ltu-formula-hybrid/pimu/documents/schematic.png

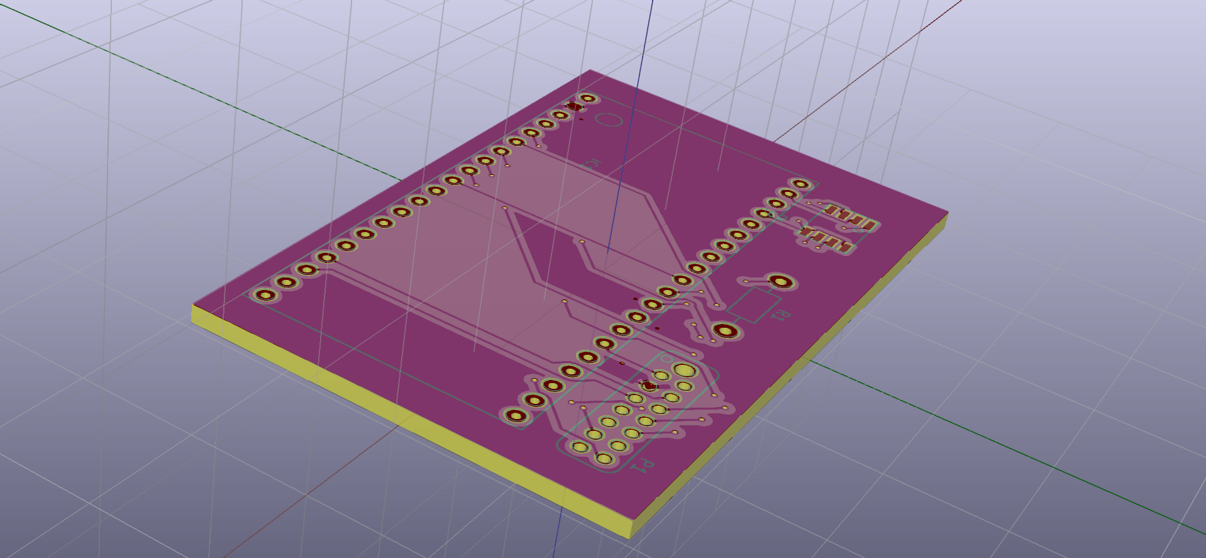
documents/schematic.png
