ltu-formula-hybrid/pimu/(list of files, cad)

Other CAD files:
documents/schematic.kicad_pcb.ipt
