ltu-formula-hybrid/pimu/documents/schematic.pdf

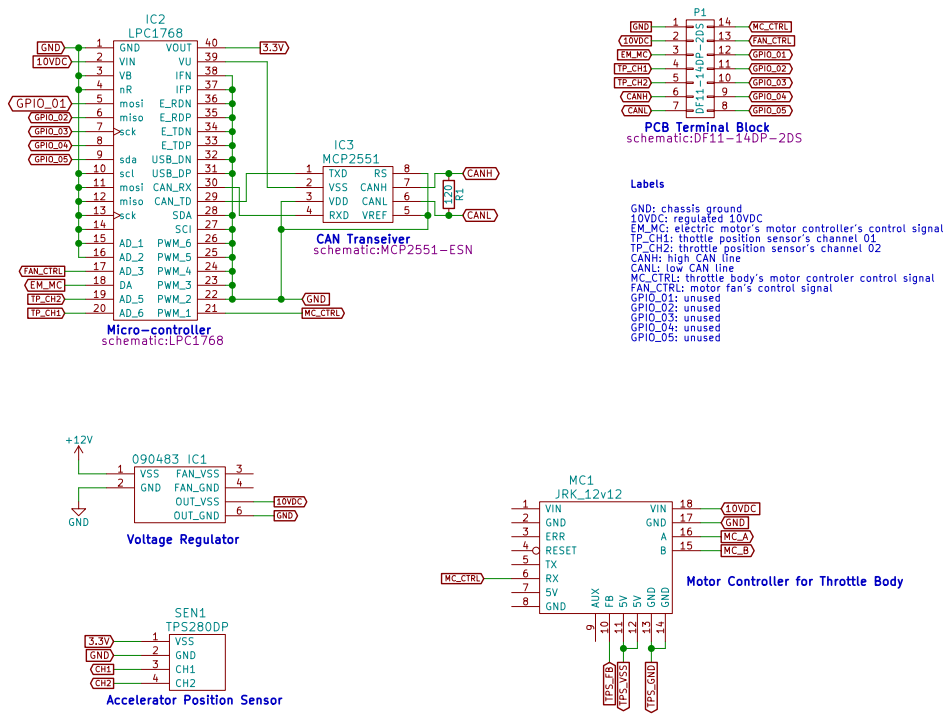
[picture p4: page 1]

10VDC: regulated 10VDC
EM_MC: electric motor's motor controller's control signal
TP_CH1: thottle position sensor's channel 01
TP_CH2: throttle position sensor's channel 02
CANH: high CAN line CANL: low CAN line MC_CTRL: throttle body's motor controler control signal

Motor Controller for Throttle Body
