ltu-formula-hybrid/pimu/documents/schematic-B.Cu.pdf

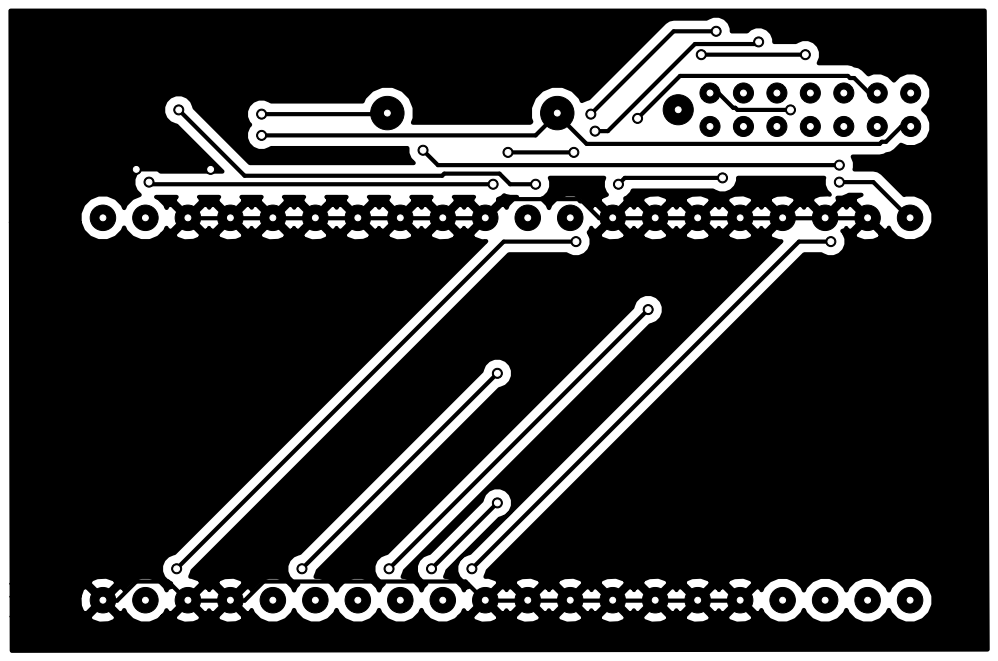
[picture p5: page 1]
