ltu-formula-hybrid/pimu/documents/schematic-F.Cu.pdf

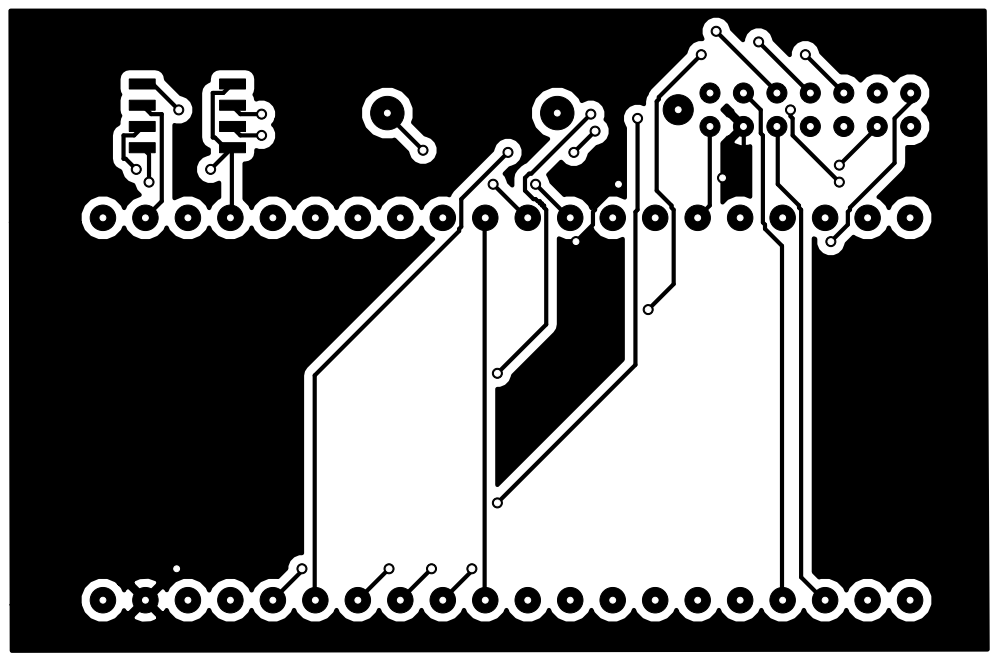
[picture p6: page 1]
