ltu-formula-hybrid/pimu/documents/schematic-F.SilkS.pdf

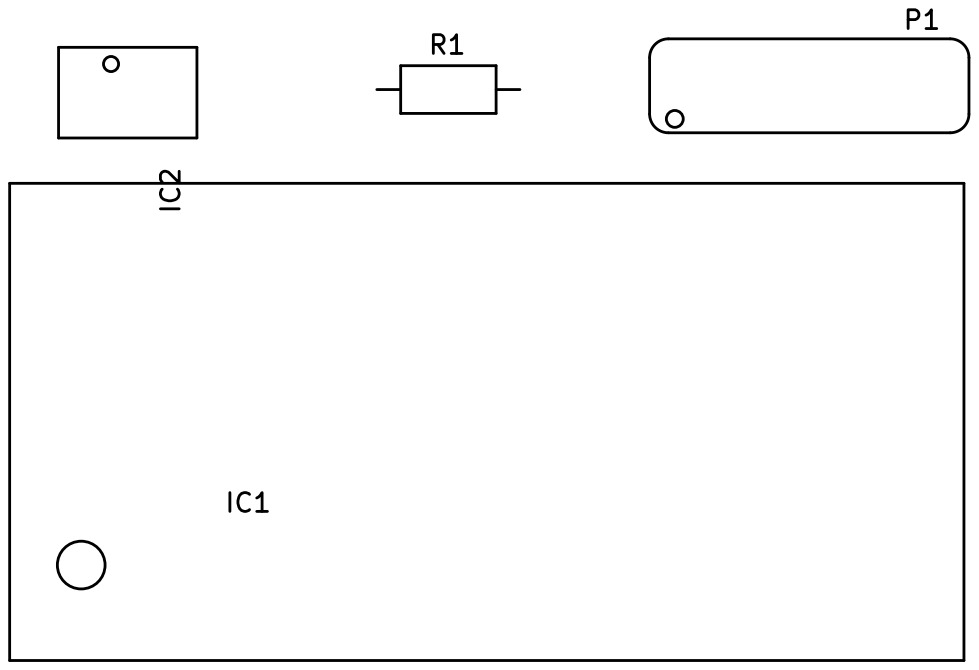
[picture p7: page 1]
