ltu-formula-hybrid/pimu/documents/schematic.kicad_pcb

## KiCad design documents/schematic.kicad_pcb (2016-03-19)

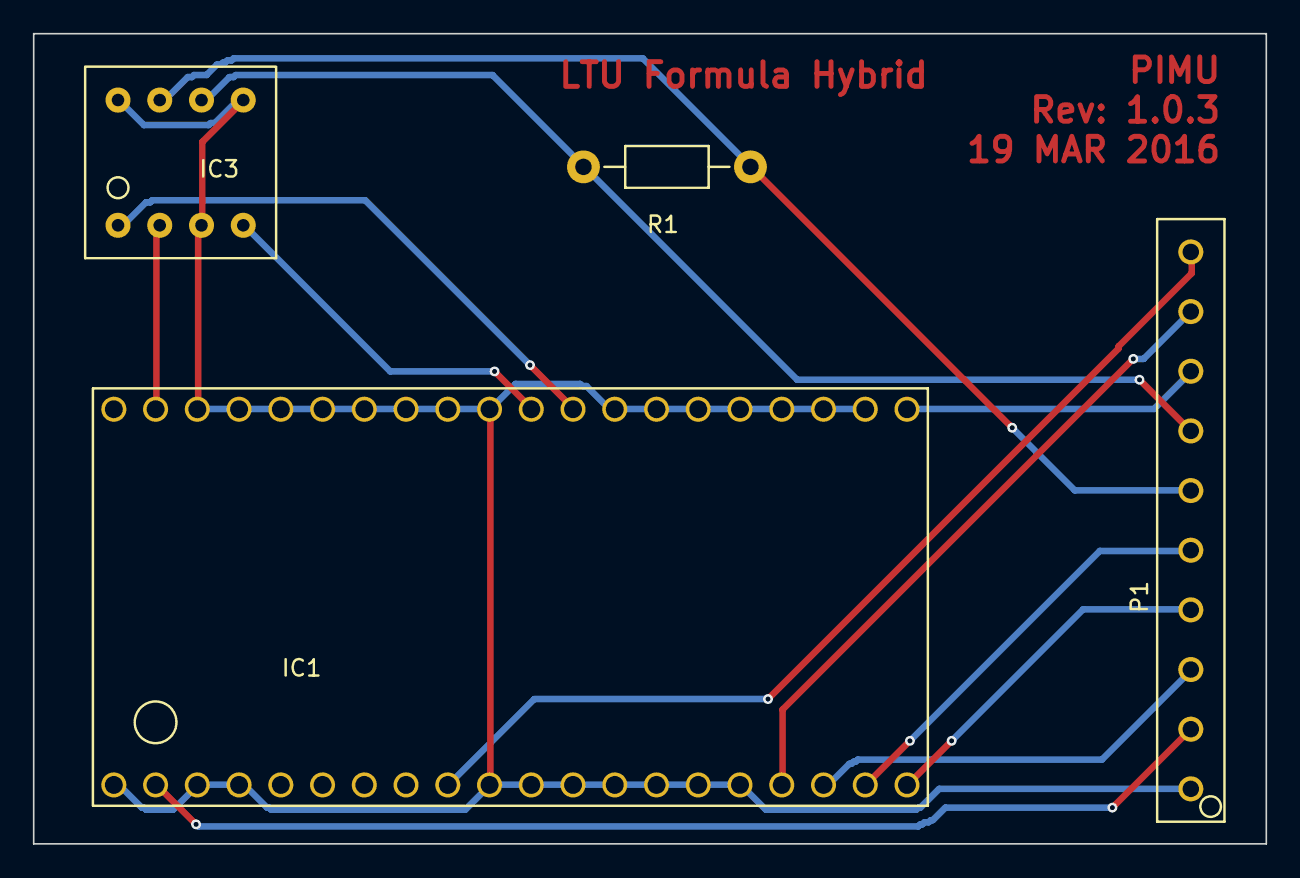
[picture p8: board schematic.kicad_pcb from above]

Board: 2 copper layers, 75.0 x 49.3 mm, 4 parts (0 on the bottom side), 13 nets.

Parts:
IC1: LPC1768
IC3: MCP2551; MCP2551-ESN
P1: CONN_01X10; CONN_01X10_CUST
R1: 120; Resistor_Horizontal_RM10mm

Connections:
10VDC: IC1.2, P1.2
CANH: IC3.7, P1.6, R1.1
CANL: IC3.6, P1.7, R1.2
EM_MC: IC1.18, P1.3
FAN_CTRL: IC1.17, P1.9
GND: IC1.1, IC1.3, IC1.4, IC1.10, IC1.11, IC1.12, IC1.13, IC1.14, IC1.15, IC1.16, IC1.22, IC1.23, IC1.24, IC1.25, IC1.26, IC1.27, IC1.28, IC1.31, IC1.32, IC1.33, IC1.34, IC1.35, IC1.36, IC1.37, IC1.38, IC3.3, IC3.5, IC3.8, P1.1
MC_CTRL: IC1.21, P1.8
unnamed: IC1.29, IC3.1
unnamed: IC1.30, IC3.4
unnamed: IC1.39, IC3.2
STARTER_SIG: IC1.9, P1.10
TP_CH1: IC1.20, P1.4
TP_CH2: IC1.19, P1.5
