ltu-formula-hybrid/pimu/PwmIn.cpp

/* mbed PwmIn Library
 * Copyright (c) 2008-2010, sford
 *
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
 * THE SOFTWARE IS PROVIDED "AS IS", WITHOUT WARRANTY OF ANY KIND, EXPRESS OR
 * IMPLIED, INCLUDING BUT NOT LIMITED TO THE WARRANTIES OF MERCHANTABILITY,
 * FITNESS FOR A PARTICULAR PURPOSE AND NONINFRINGEMENT. IN NO EVENT SHALL THE
 * AUTHORS OR COPYRIGHT HOLDERS BE LIABLE FOR ANY CLAIM, DAMAGES OR OTHER
 * LIABILITY, WHETHER IN AN ACTION OF CONTRACT, TORT OR OTHERWISE, ARISING FROM,
 * OUT OF OR IN CONNECTION WITH THE SOFTWARE OR THE USE OR OTHER DEALINGS IN
 * THE SOFTWARE.
 */
 
#include "PwmIn.h"
 
PwmIn::PwmIn(PinName p) : _p(p) {
    _p.rise(this, &PwmIn::rise);
    _p.fall(this, &PwmIn::fall);
    _period = 0.0;
    _pulsewidth = 0.0;
    _t.start();
}
 
float PwmIn::period() {
    return _period;
}
 
float PwmIn::pulsewidth() {
    return _pulsewidth;
}
 
float PwmIn::dutycycle() {
    return _pulsewidth / _period;
}
 
void PwmIn::rise() {
    _period = _t.read();
    _t.reset();
}
 
void PwmIn::fall() {
    _pulsewidth = _t.read();
}
 
