ltu-formula-hybrid/pimu/(commit log)

2016-01-09 Throttle body idles
2016-02-16 Added docs and updated code
    [schematic.kicad_pcb, schematic.sch]
2016-02-20 Working CAN testing
    [schematic.sch]
2016-02-25 yasaCut off [FIX]
    fixed yasaCutOff code
    [main.cpp]
2016-03-15 Documentation and PCB design
    [schematic.kicad_pcb, schematic.sch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]
2016-04-16 With PWM IN libs
    not actually needed
    [schematic.kicad_pcb.ipt]
